SavvasSampaziotis/Quadcopter/README.md

# Quadcopter
The Quadcopter Project me and my buddy Orestis Kotzamanidis started on our second year in engineering

Serious clean-up is needed...

This repository contains our data results from the motor-propeller modelling of the system. 
It contains 
  * the code for the microcontroller
  * the matlab scripts for the system parameter estimation
  * Some of the documentation we (tried) to write for each other
