SavvasSampaziotis/Quadcopter/Preparation Data Footage and Tools/README.md

#Preperation and Tools

This folder contains dome documents written for our sake, regarding the materials, engines and electronic components that we researched.
Lazaros Kalfas helped out for that :)

* **MotorProp Benchmarks**
    - Contains screenshots from an online tool we found back in the days that helped us familiarise ourselves with

* **PropCalc**
    - Tool for thrust estimation. Helped us in choosing the propellers
