SavvasSampaziotis/Quadcopter/Preparation Data Footage and Tools/Future Sensors.docx

# Altimeters - Sparkfun

Altimeter Barometric Pressure Sensor - BMP085 - Discontinued

https://www.sparkfun.com/products/12882

Altimeter Overview

https://www.sparkfun.com/tutorials/253

T5403 Barometric Pressure Sensor

Δεν βρήκα τις libraries ,με πρώτη αναζήτηση

https://www.sparkfun.com/products/12039

https://learn.sparkfun.com/tutorials/t5403-barometric-pressure-sensor-hookup-guide/all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

MPL3115A2 Pressure Sensor

Πρωτιμόμενο!

https://www.sparkfun.com/products/11084

https://learn.sparkfun.com/tutorials/mpl3115a2-pressure-sensor-hookup-guide
