SavvasSampaziotis/Quadcopter/Preparation Data Footage and Tools/RESOURCES.docx

Για τηλεχειρηστηριο θα χρησιμοποιησουμε PC σε πρωτη φαση.

Wireless | XBee 1mW Wire Antenna - Series 1 (802.15.4) | http://robotstore.gr/xbee-1mw-wire-antenna-series-1-802.15.4-el.html | 20.78 (x2) = 41.56 E
Motors | NTM Prop Drive Series 28-30S 900kv / 270w (short shaft version) (EU warehouse) | http://www.hobbyking.com/ hobbyking/store/ (http://www.hobbyking.com/%20hobbyking/store/) __45000__NTM_Prop_ Drive_Series_28_ 30S_900kv_270w_short_shaft_ version_EU_warehouse_.html | 13.41 (x4) = 53.64 Ε
ESCs | Turnigy Multistar 30 Amp Multi-rotor Brushless ESC 2-4S (OPTO) | http://www.hobbyking.com/ hobbyking/ (http://www.hobbyking.com/%20hobbyking/) store/__27776__Turnigy _Multistar_30_Amp_ Multi_rotor_Brushless_ ESC_2_4S_OPTO_.html | 8.69 (x4) = 34.76E
PROP | Slow Fly Electric Prop 11x4.7R SF (4 pc - Green Right Hand Rotation) | http://www.hobbyking.com/ hobbyking/store/ (http://www.hobbyking.com/%20hobbyking/store/) __22453__Slow_Fly_Electric_ Prop_11x4_7R_SF_4_pc _Green_Right_Hand_ Rotation_.html | 2.96 (x4) =11.84E
BATTERY | ?????
IMU | ??????
