SavvasSampaziotis/Quadcopter/Preparation Data Footage and Tools/PropCalc_en_Win/PropCalc_en_Win/PCHelp/PCScreens_en/Main.jpg

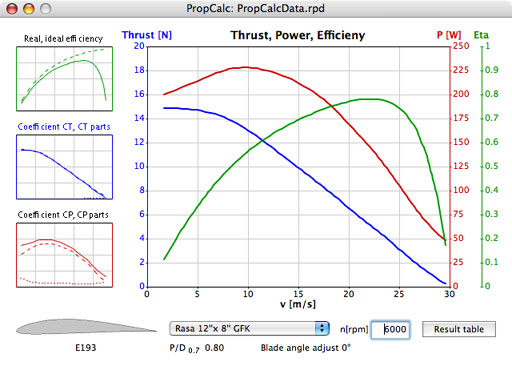
Preparation Data Footage and Tools/PropCalc_en_Win/PropCalc_en_Win/PCHelp/PCScreens_en/Main.jpg
