SavvasSampaziotis/Quadcopter/Preparation Data Footage and Tools/PropCalc_en_Win/PropCalc_en_Win/PCHelp/PCScreens_en/Polare.jpg

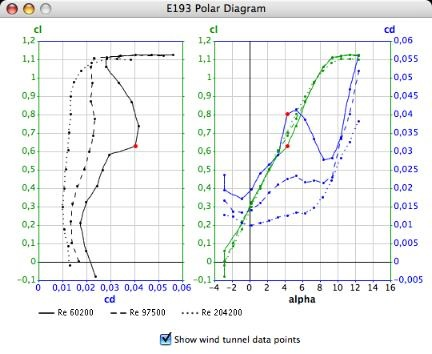
Preparation Data Footage and Tools/PropCalc_en_Win/PropCalc_en_Win/PCHelp/PCScreens_en/Polare.jpg
