SavvasSampaziotis/Quadcopter/Preparation Data Footage and Tools/PropCalc_en_Win/PropCalc_en_Win/PCHelp/PCScreens_en/Preferences.jpg

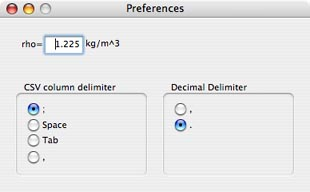
Preparation Data Footage and Tools/PropCalc_en_Win/PropCalc_en_Win/PCHelp/PCScreens_en/Preferences.jpg
