SavvasSampaziotis/Quadcopter/Preparation Data Footage and Tools/PropCalc_en_Win/PropCalc_en_Win/PCHelp/PCScreens_en/Propeller.jpg

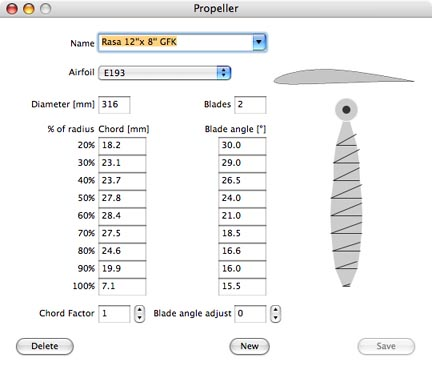
Preparation Data Footage and Tools/PropCalc_en_Win/PropCalc_en_Win/PCHelp/PCScreens_en/Propeller.jpg
