SavvasSampaziotis/Quadcopter/Preparation Data Footage and Tools/MotorProp Benchmarks/QUAD.xlsx

Όνομα/Λίνκ/Σχόλια | Τιμή | Προτείνεται | Εικόνα eCalc
 |  | x=όχι, ν = ναι
Turnigy Multistar 2209-980Kv 14Pole Multi-Rotor Outrunner
http://www.hobbyking.com/hobbyking/store/__39034__Turnigy_Multistar_2209_980Kv_14Pole_Multi_Rotor_Outrunner.html | 11.19 | x | όχι
καλό με πρώτη ματιά αλλα στο ecalc πήγαν όλα στραβα. Η βελτιωμένη έκδοσή του είναι ο 2213 (παρακάτω)
MT2213-935KV MultiStar Motor and Propeller Combo 10-4.5 CW CCW
http://www.hobbyking.com/hobbyking/store/__43884__MT2213_935KV_MultiStar_Motor_and_Propeller_Combo_10_4_5_CW_CCW.html | 11.27 | ν. | ναι
Σιγουράκι συνυασμός. Θετικά σχόλια
Turnigy Multistar 2213-980Kv 14Pole Multi-Rotor Outrunner
http://www.hobbyking.com/hobbyking/store/__39036__Turnigy_Multistar_2213_980Kv_14Pole_Multi_Rotor_Outrunner.html | 11.53 | v. | ναι
Είναι η βελτιωμένη έκδοση του2209.
NTM Prop Drive Series 28-30S 900kv / 270w (short shaft version) |  | πολύ καλός
http://www.hobbyking.com/hobbyking/store/__25081__NTM_Prop_Drive_Series_28_30S_900kv_270w_short_shaft_version_.html | 11.54 | ν. | ναι
όχι αρκετές πληροφορίες, περιέχει thrust table. Την προτείνει το ένστικτό μου. πληρης γκάμα spare parts
NTM Prop Drive 28-30S 800KV / 300W Brushless Motor (short shaft version)
http://www.hobbyking.com/hobbyking/store/__25080__NTM_Prop_Drive_28_30S_800KV_300W_Brushless_Motor_short_shaft_version_.html | 11.77 |  | ναι
περιέχει thrust table, προτιμότερο από το αποπάνω
NTM Prop Drive 28-26 1000KV / 235W (short shaft version)
http://www.hobbyking.com/hobbyking/store/__25082__NTM_Prop_Drive_28_26_1000KV_235W_short_shaft_version_.html | 12.31 |  | ναι
καποιοι ανεφεραν προβλήματα με το τρέμουλο. Έχει thrust table.
Turnigy Multistar 2216-800Kv 14Pole Multi-Rotor Outrunner |  | v. Χρόνος πτήσης
http://www.hobbyking.com/hobbyking/store/__39037__Turnigy_Multistar_2216_800Kv_14Pole_Multi_Rotor_Outrunner.html | 12.86 | καλούτσικα σχόλια | ναι
Η καλύτερη σχέση kv/χρόνου πτήσης! (αλλα όχι στα MaxedOut) |  | έχει accesories
AX-2810Q-750KV Brushless Quadcopter Motor
http://www.hobbyking.com/hobbyking/store/__25556__AX_2810Q_750KV_Brushless_Quadcopter_Motor.html | 16.03 | x | όχι
Δεν μ άρεσε.
Turnigy 4208 620kv Brushless Multi-Rotor Motor
http://www.hobbyking.com/hobbyking/store/__22193__Turnigy_4208_620kv_Brushless_Multi_Rotor_Motor.html | 17.36 | x | όχι
Το eCalc λέει κακό μανουβράρισμα. Θέλει μεγάλες προπέλες.
Turnigy Multistar 4220-880Kv 16Pole Multi-Rotor Outrunner
http://www.hobbyking.com/hobbyking/store/__38455__Turnigy_Multistar_4220_880Kv_16Pole_Multi_Rotor_Outrunner.html | 17.52 |  | ναι
Turnigy Multistar 4220-650Kv 16Pole Multi-Rotor Outrunner
http://www.hobbyking.com/hobbyking/store/__38456__Turnigy_Multistar_4220_650Kv_16Pole_Multi_Rotor_Outrunner.html | 17.93 | x | ναι
Για 11άρες προπέλες. Μικρό ωφέλιμο βάρος
Turnigy 5017 620kv Brushless Multi-Rotor Motor
http://www.hobbyking.com/hobbyking/store/__41485__Turnigy_5017_620kv_Brushless_Multi_Rotor_Motor.html | 18.54 | x | όχι
Ακόμα πιο αργή έκδοση της παρακάτω. Δεν προτείνεται, θέλει μεγάλη προπέλα. Περιέχει thrust table
Turnigy Multistar 3525-650Kv 14Pole Multi-Rotor Outrunner
http://www.hobbyking.com/hobbyking/store/__36765__Turnigy_Multistar_3525_650Kv_14Pole_Multi_Rotor_Outrunner.html | 19.33 | x | ναι
Μεγάλες προπέλες
Turnigy Multistar 2814-700Kv 14Pole Multi-Rotor Outrunner
http://www.hobbyking.com/hobbyking/store/__39038__Turnigy_Multistar_2814_700Kv_14Pole_Multi_Rotor_Outrunner.html | 20.41 | ν. ακριβός | ναι
Turnigy Multistar 3525-850Kv 14Pole Multi-Rotor Outrunner
http://www.hobbyking.com/hobbyking/store/__36767__Turnigy_Multistar_3525_850Kv_14Pole_Multi_Rotor_Outrunner.html | 21.25 | ν. ακριβός | ναι
