SavvasSampaziotis/Quadcopter/MATLAB/MOTOR MODELLING RESULTS/Graphs/approximation-graph.jpg

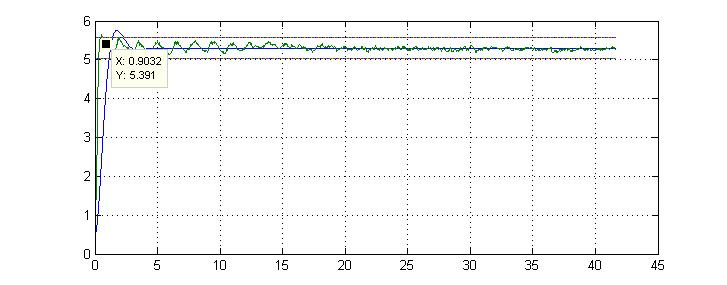
MATLAB/MOTOR MODELLING RESULTS/Graphs/approximation-graph.jpg
