SavvasSampaziotis/Quadcopter/MATLAB/MOTOR MODELLING RESULTS/Graphs/failed.jpg

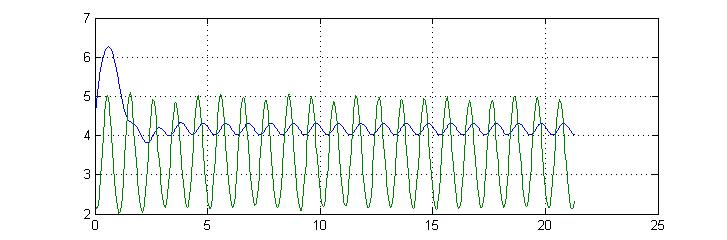
MATLAB/MOTOR MODELLING RESULTS/Graphs/failed.jpg
