SavvasSampaziotis/Quadcopter/MATLAB/MOTOR MODELLING RESULTS/Graphs/Motor-bode.jpg

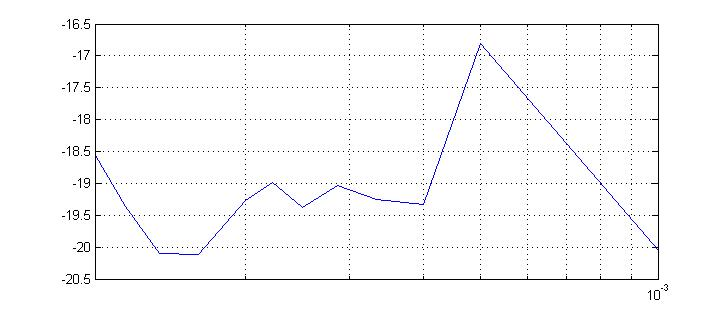
MATLAB/MOTOR MODELLING RESULTS/Graphs/Motor-bode.jpg
