SavvasSampaziotis/Quadcopter/Preparation Data Footage and Tools/MotorProp Benchmarks/Banned/Turnigy Multistar 3525-650Kv 14Pole Multi-Rotor Outrunner.png

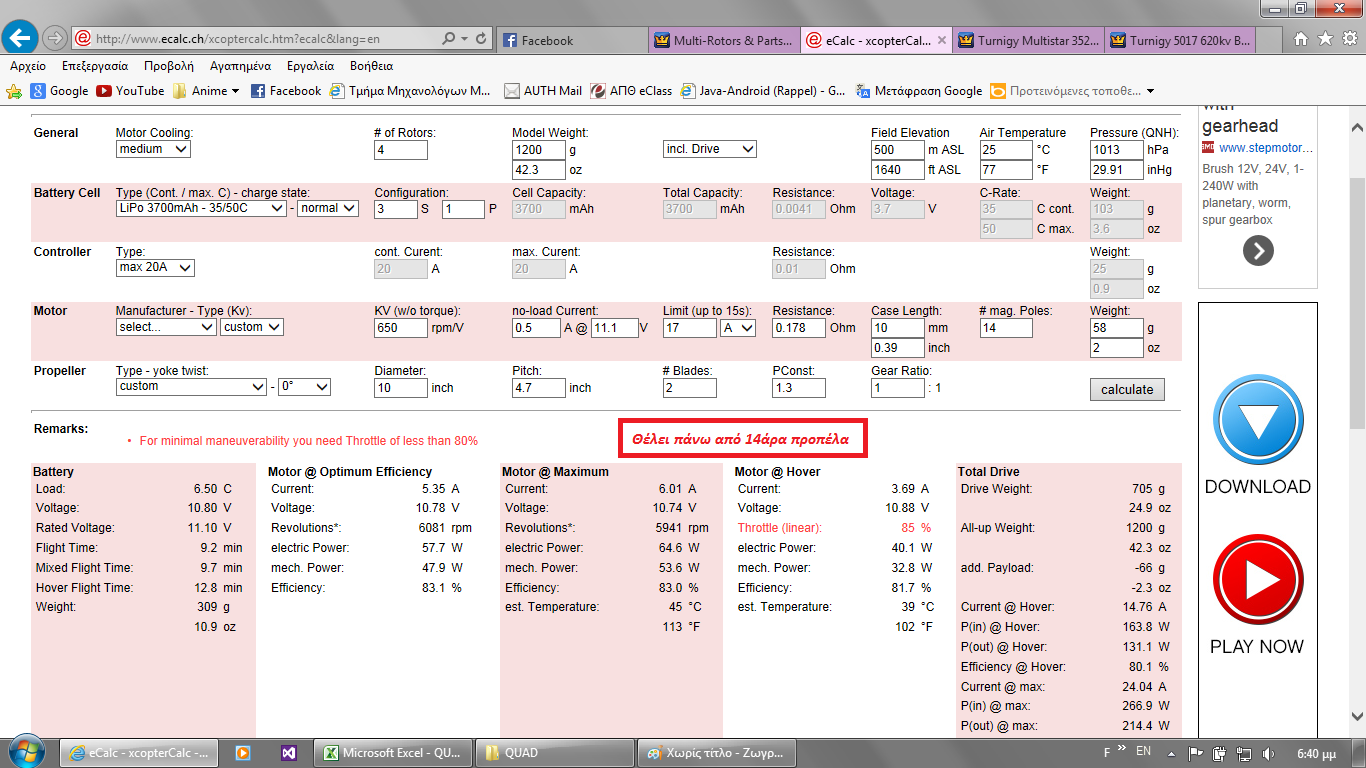
Preparation Data Footage and Tools/MotorProp Benchmarks/Banned/Turnigy Multistar 3525-650Kv 14Pole Multi-Rotor Outrunner.png
