SavvasSampaziotis/Quadcopter/Preparation Data Footage and Tools/MotorProp Benchmarks/Banned/Turnigy Multistar 4220-650Kv 16Pole Multi-Rotor Outrunner.png

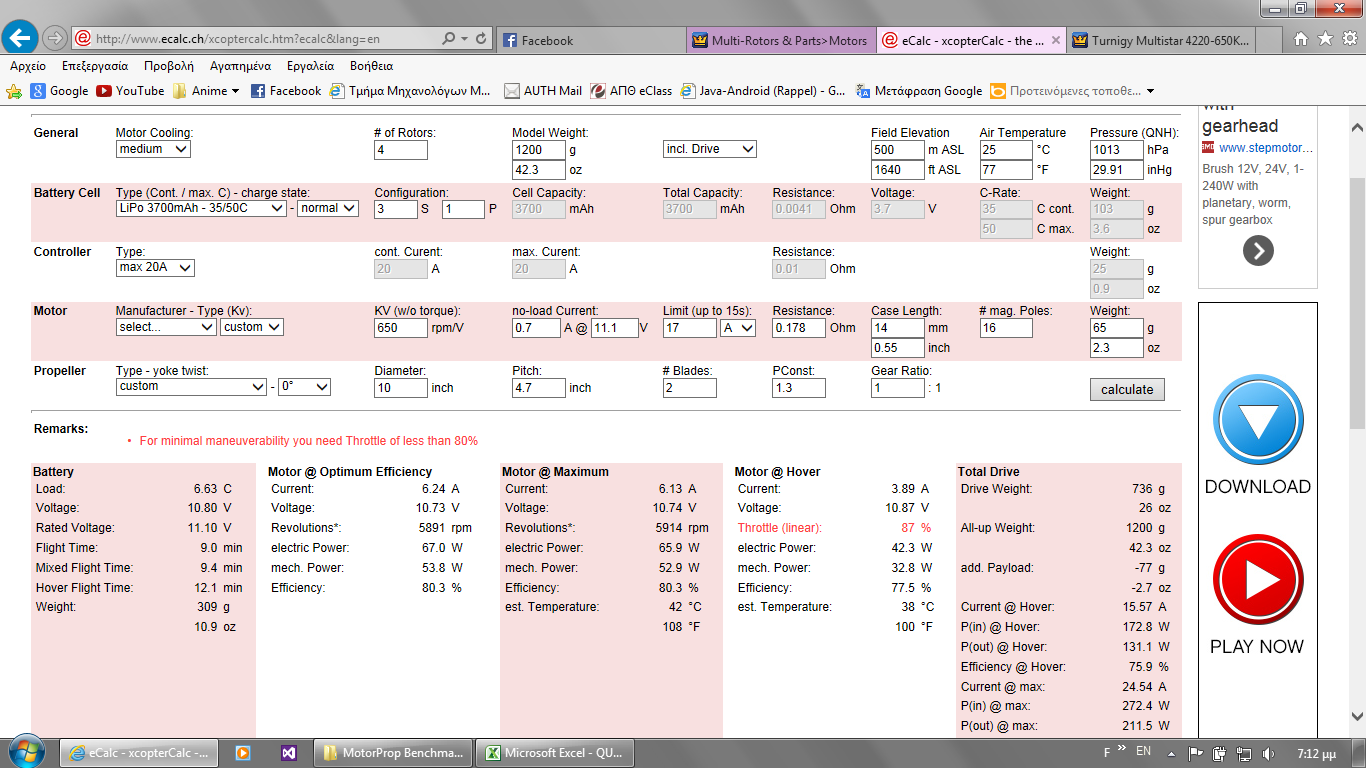
Preparation Data Footage and Tools/MotorProp Benchmarks/Banned/Turnigy Multistar 4220-650Kv 16Pole Multi-Rotor Outrunner.png
