SavvasSampaziotis/Quadcopter/Preparation Data Footage and Tools/MotorProp Benchmarks/MaxedOut/Turnigy Multistar 2213-980Kv 14Pole Multi-Rotor Outrunner.png

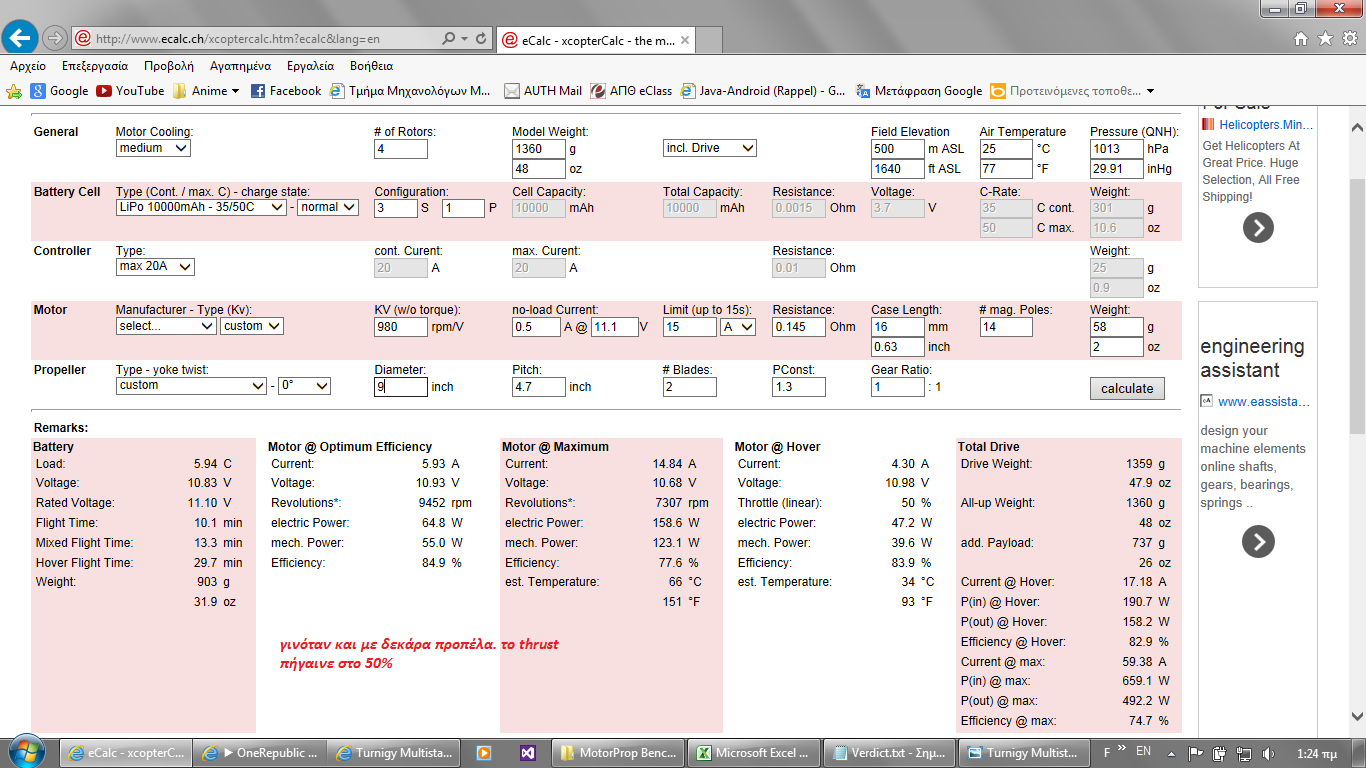
Preparation Data Footage and Tools/MotorProp Benchmarks/MaxedOut/Turnigy Multistar 2213-980Kv 14Pole Multi-Rotor Outrunner.png
