SavvasSampaziotis/Quadcopter/Preparation Data Footage and Tools/MotorProp Benchmarks/MT2213-935KV MultiStar Motor and Propeller Combo 10-4.5 CW CCW.png

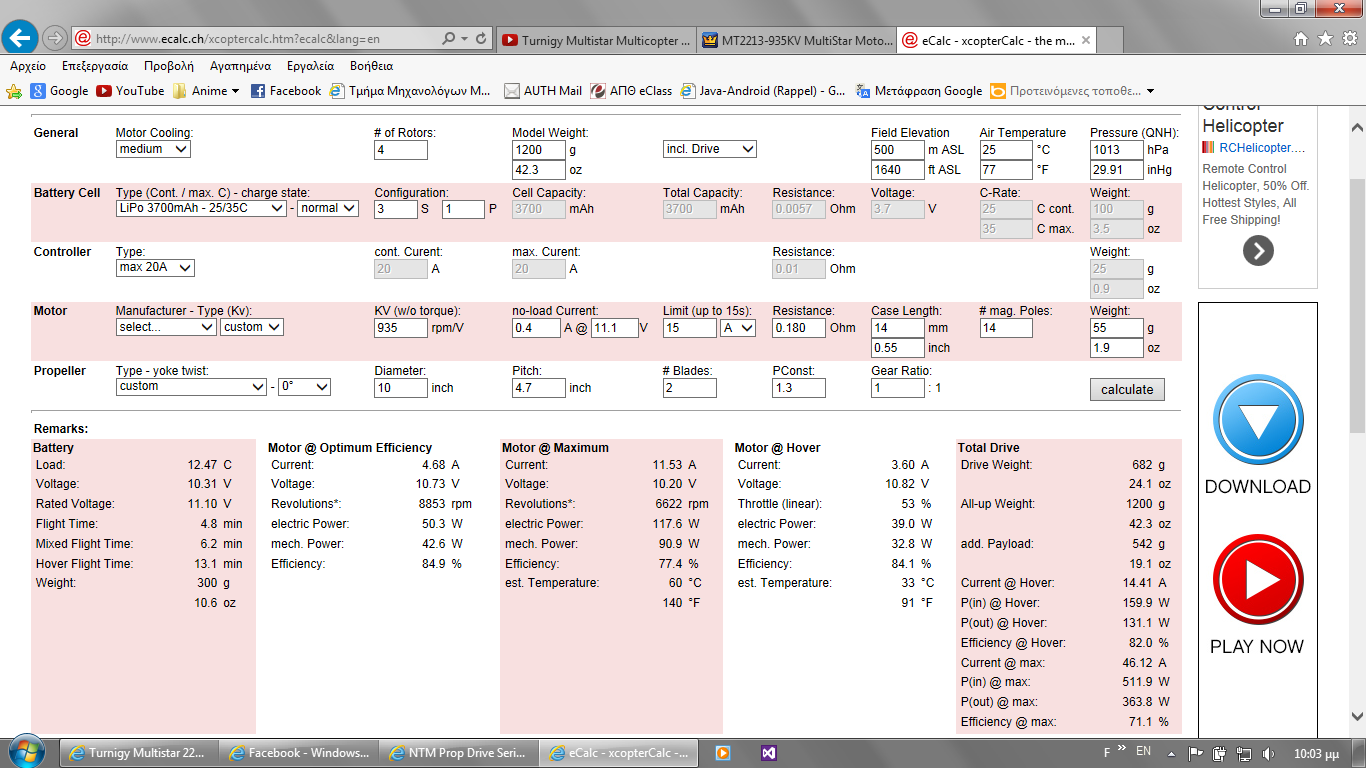
Preparation Data Footage and Tools/MotorProp Benchmarks/MT2213-935KV MultiStar Motor and Propeller Combo 10-4.5 CW CCW.png
