SavvasSampaziotis/Quadcopter/Preparation Data Footage and Tools/MotorProp Benchmarks/NTM Prop Drive 28-26 1000KV_235W (short shaft version).png

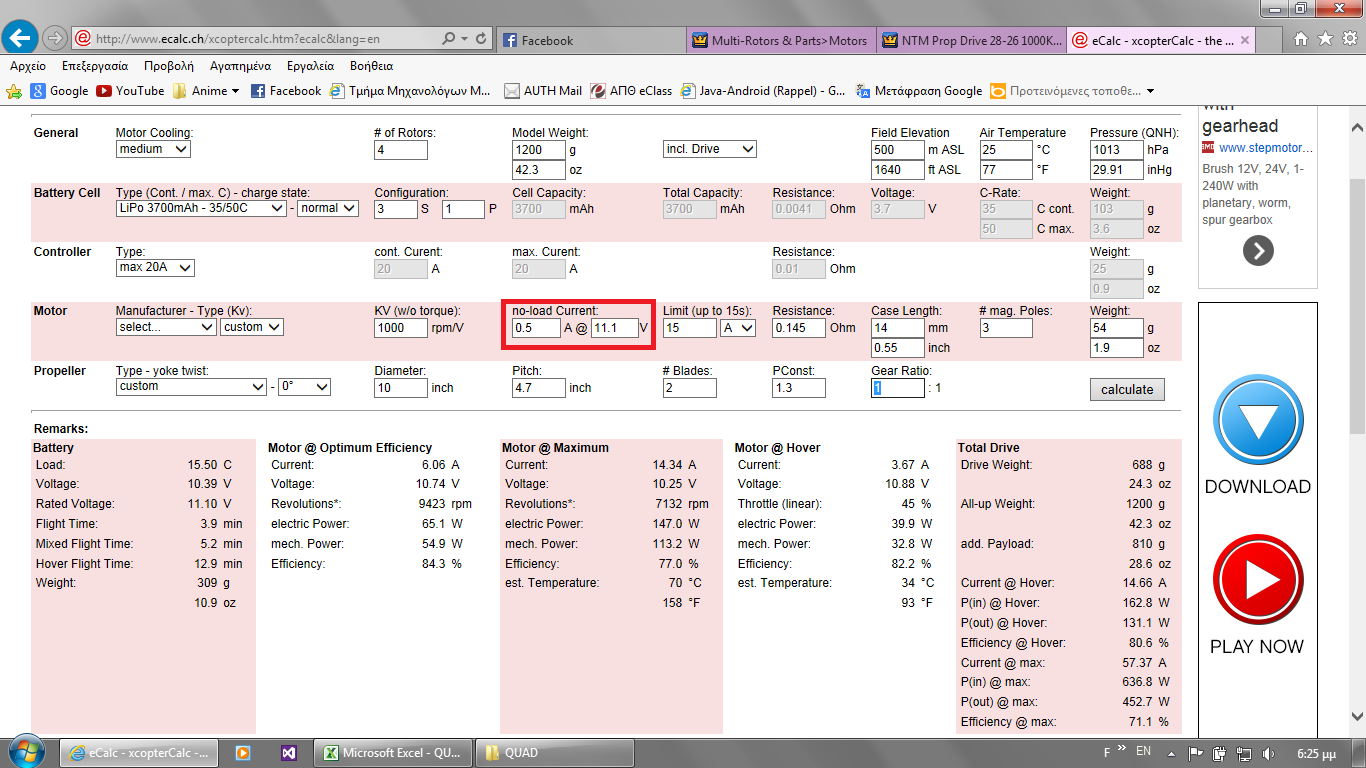
Preparation Data Footage and Tools/MotorProp Benchmarks/NTM Prop Drive 28-26 1000KV_235W (short shaft version).png
