SavvasSampaziotis/Quadcopter/Preparation Data Footage and Tools/MotorProp Benchmarks/NTM Prop Drive Series 28-30S 900kv_270w (short shaft version).png

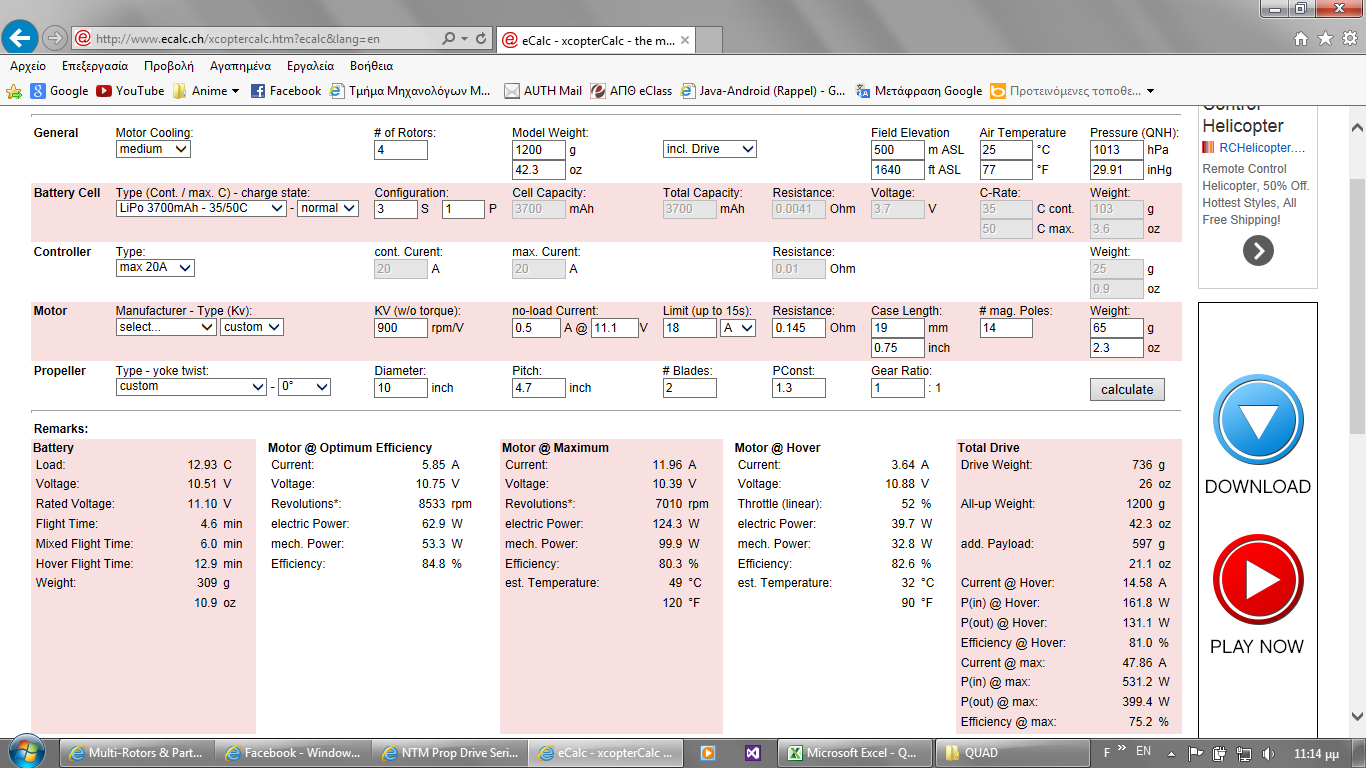
Preparation Data Footage and Tools/MotorProp Benchmarks/NTM Prop Drive Series 28-30S 900kv_270w (short shaft version).png
