SavvasSampaziotis/Quadcopter/Preparation Data Footage and Tools/MotorProp Benchmarks/Turnigy Multistar 4220-880Kv 16Pole Multi-Rotor Outrunner.png

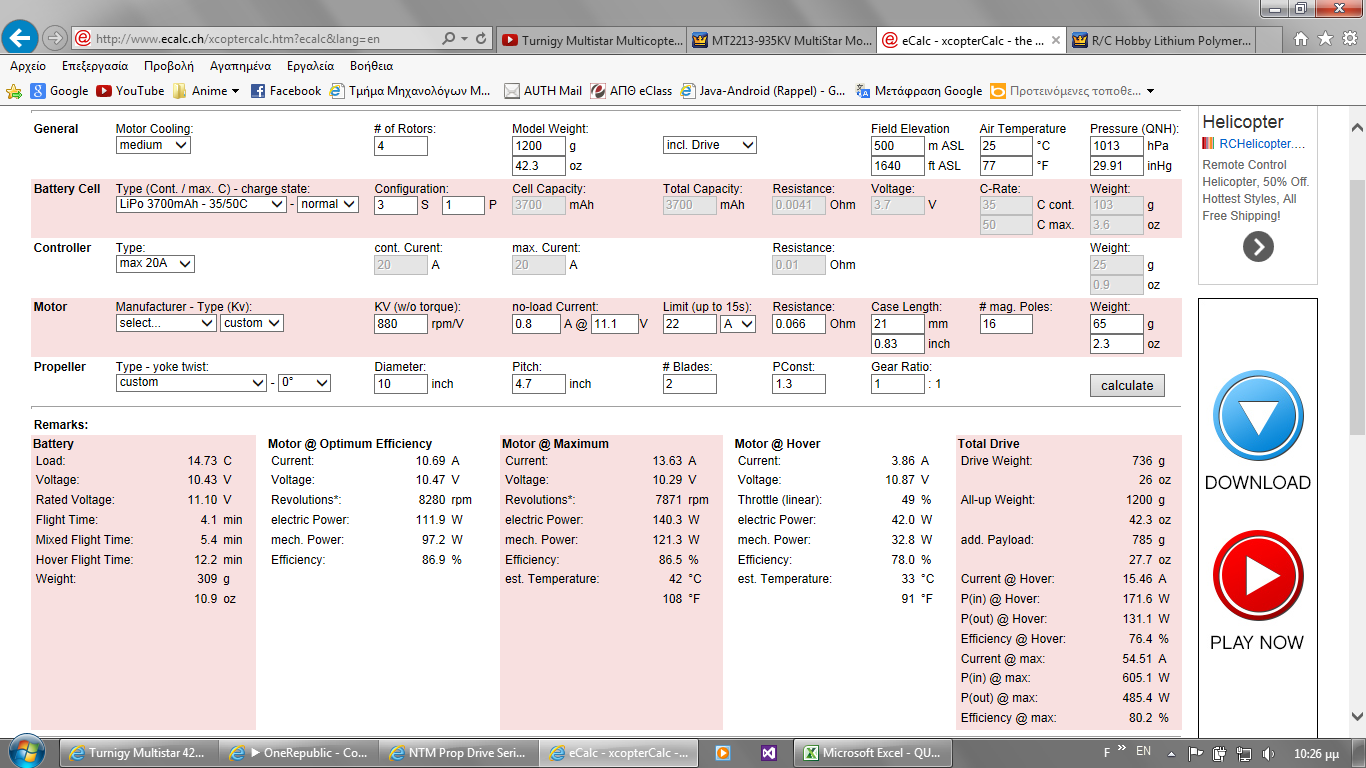
Preparation Data Footage and Tools/MotorProp Benchmarks/Turnigy Multistar 4220-880Kv 16Pole Multi-Rotor Outrunner.png
