SavvasSampaziotis/Quadcopter/(commit log)

2017-01-18 All the files
    Except the external documentation of the HW and SW used as well as our
    photo and video archives of the experimentation.
    [Motor_DCSweep_110815.csv, Pendulum_AC_1000.csv, Pendulum_AC_10000.csv, Pendulum_AC_1000_OLD.csv, Pendulum_AC_10sec.csv, Pendulum_AC_15000.csv, Pendulum_AC_2000.csv, Pendulum_AC_20000.csv]
2017-01-18 Modified some Directories
    Renaming folder "Μετρήσεις" to measurements and removing some PowerPoint
    presentations from the project entirely
    [Pendulum_Constant_100.csv, Pendulum_Constant_25.csv, Pendulum_Constant_50.csv, Pendulum_Constant_75.csv]
